AlexanderAdelAU/TMS9900-SBC/Schematics/Readme.md

This folder is a list of the latest and earlier schematics.
