AlexanderAdelAU/TMS9900-SBC/images/Drawings.pptx

TMS99105 SBC Memory Map

Application Memory

0000-F000

BDOS
BDOS.A99

FDC BIOS
MONITOR.A99

DEBUG Monitor
TIMON.A99

RAM

D800-E33C

E600-EE2E

F000-FFFF

ROM

## Slide 2

3 ¼ FDD

TMS99105 SBC

RS232

PC Power
Supply

## Slide 3

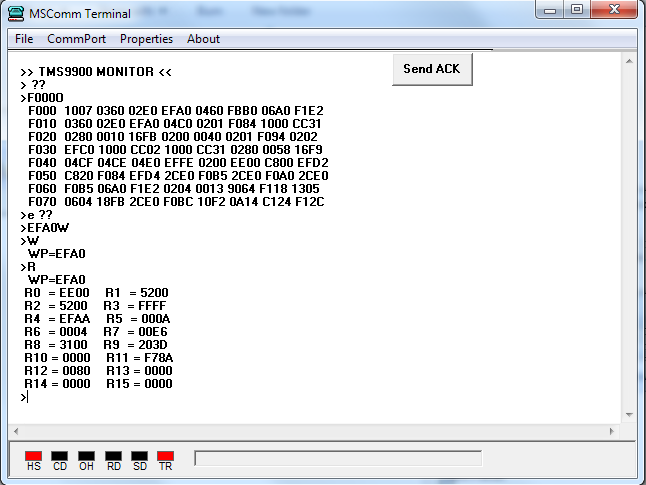
[picture p8: figure]

## Slide 4

0000H

2732 EPROM

Mapped out and filled with FFH

DEBUG Monitor

E000H

ROM Address Space

0800H

F000H

SBC Address Space

HIGH Byte

LOW Byte

1000H

FFFFH

## Slide 5

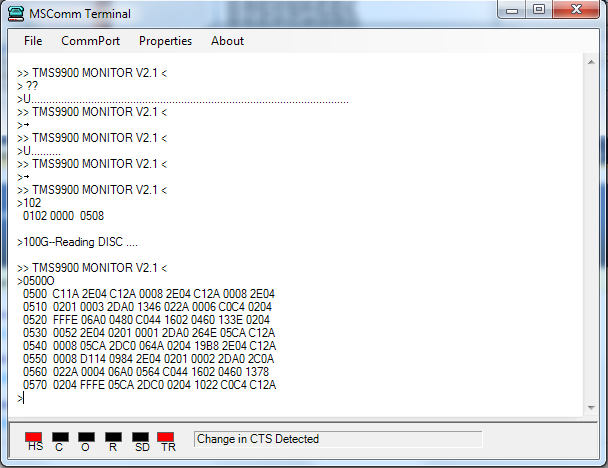
[picture p9: figure]

Reading in MONITOR.H99

Reading in READSEC.H99

Specify Track 5, Sector 8

Dumping Buffer at 0500H
