AlexanderAdelAU/TMS9900-SBC/images/2015-01-13 10.45.29.jpg

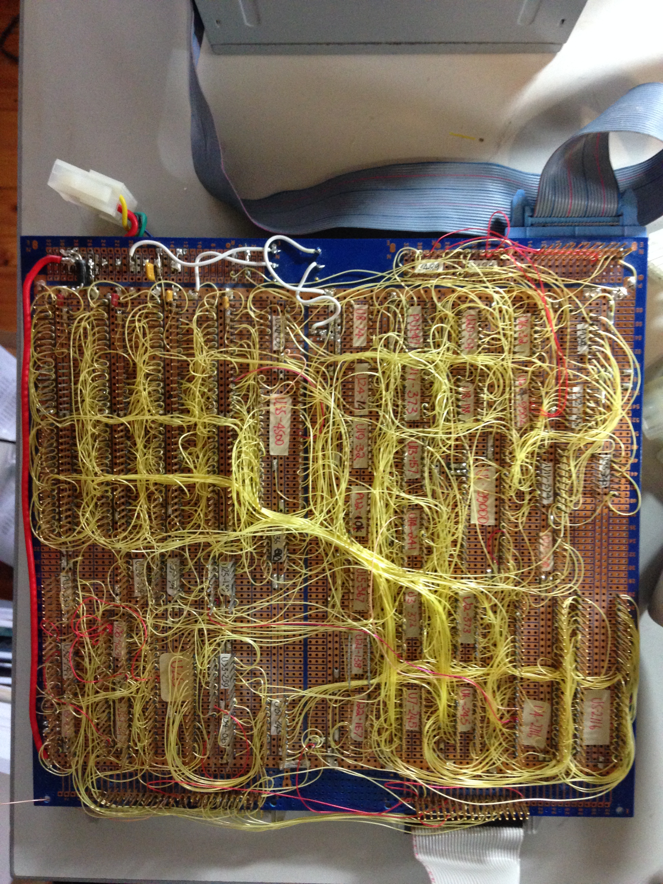
images/2015-01-13 10.45.29.jpg
