AlexanderAdelAU/TMS9900-SBC/images/2015-01-13 10.47.38.jpg

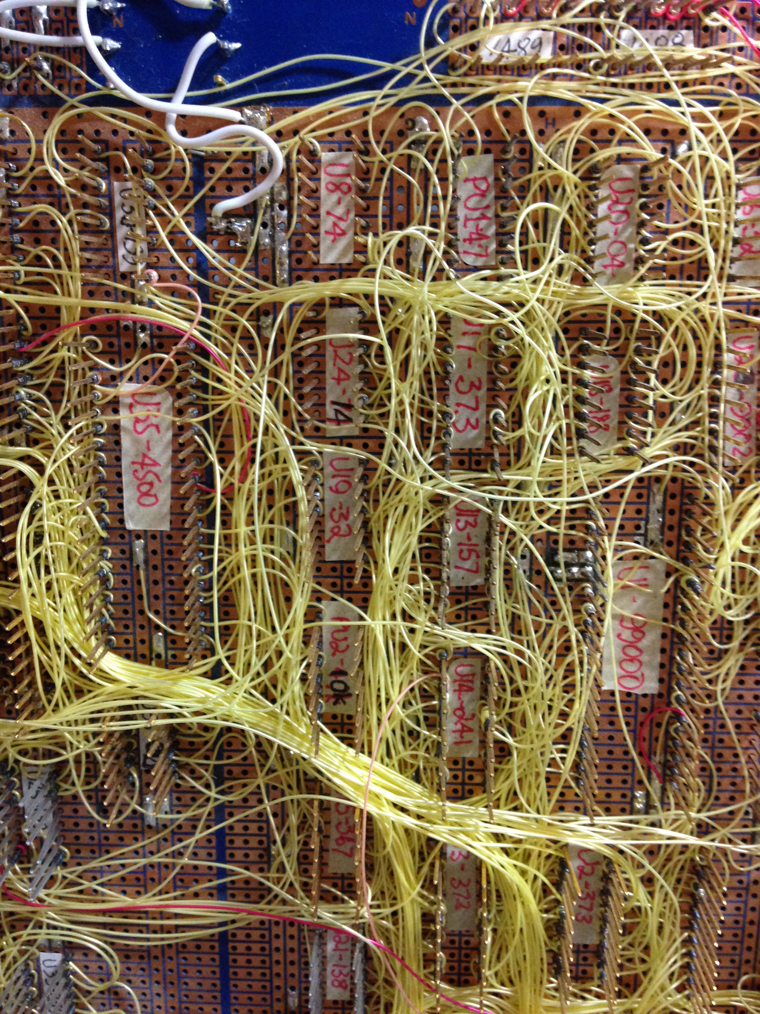
images/2015-01-13 10.47.38.jpg
