AlexanderAdelAU/TMS9900-SBC/images/CommunicationsInterface.png

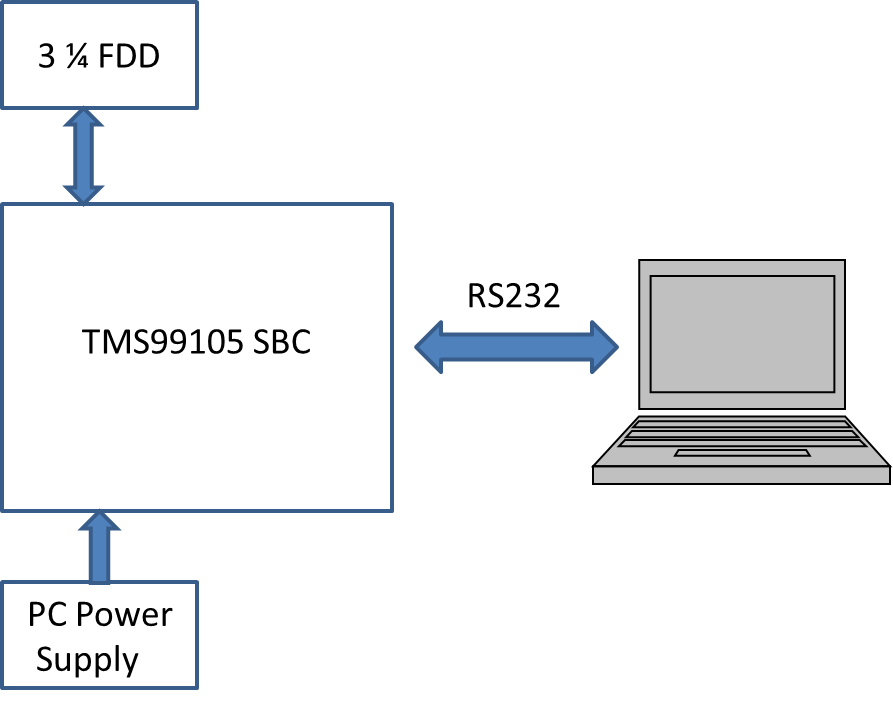
images/CommunicationsInterface.png
