AlexanderAdelAU/TMS9900-SBC/images/MemoryMap.jpg

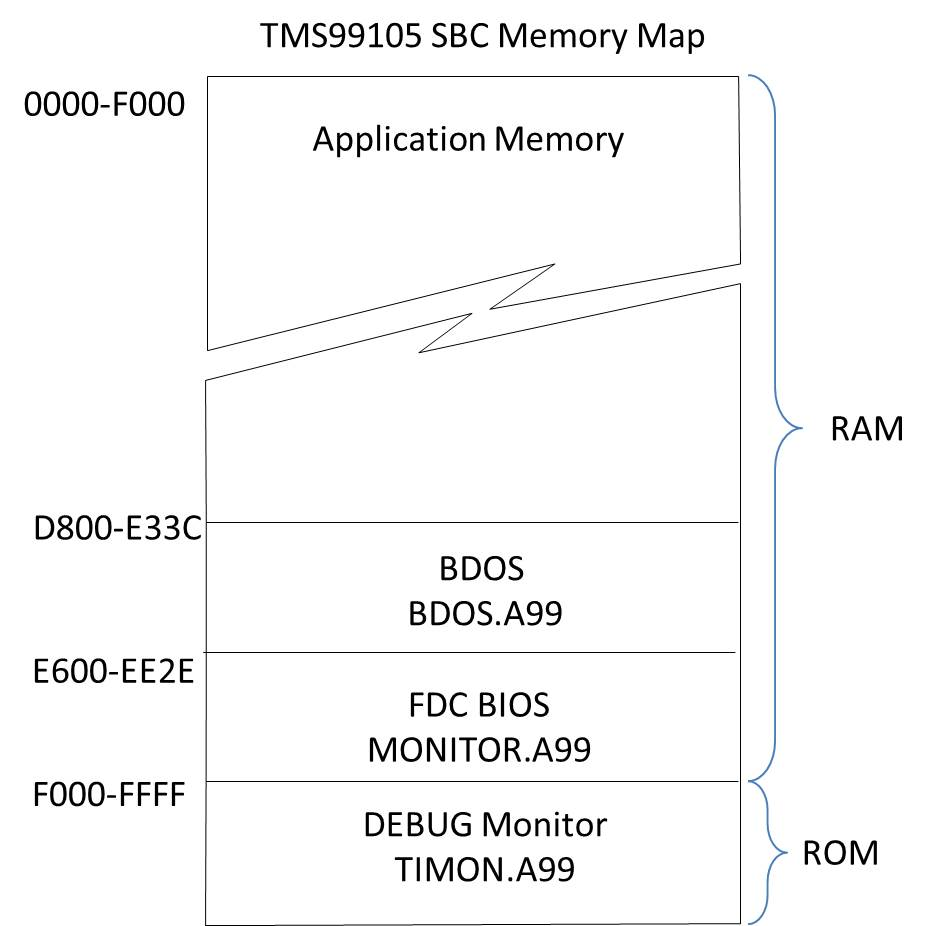
images/MemoryMap.jpg
