AlexanderAdelAU/TMS9900-SBC/images/MemoryMap.png

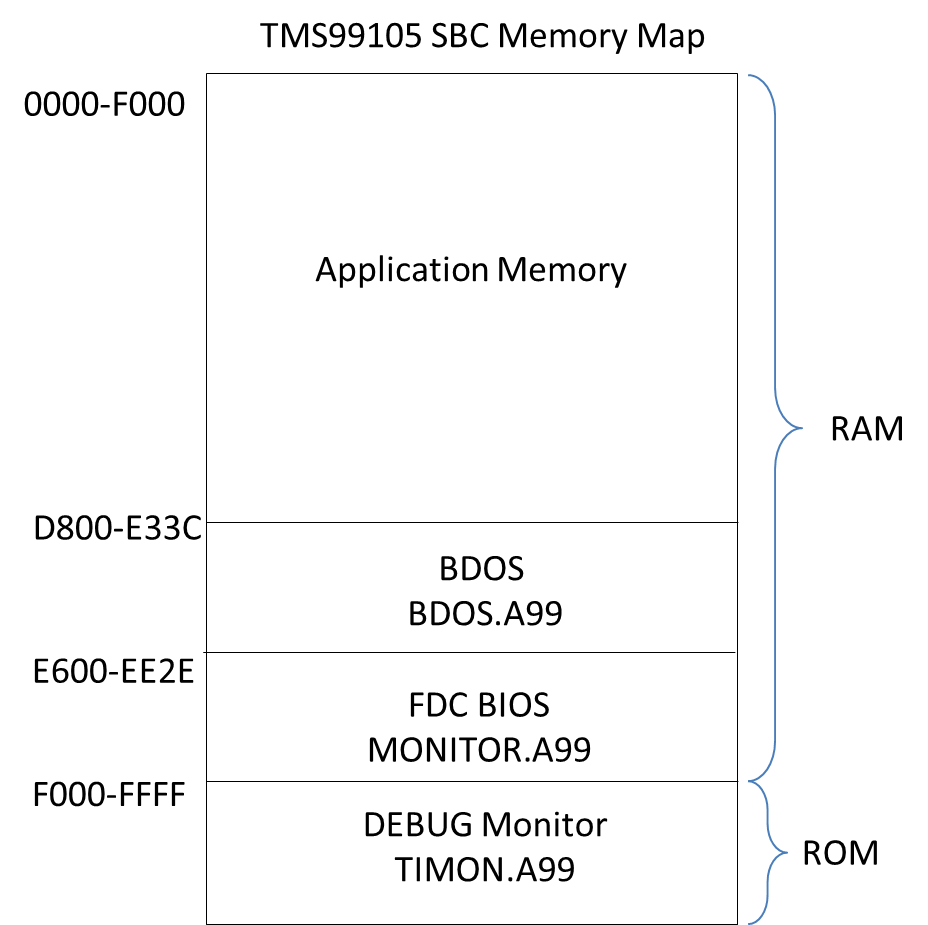
images/MemoryMap.png
