AlexanderAdelAU/TMS9900-SBC/images/TMS9900 Chip SBC.jpg

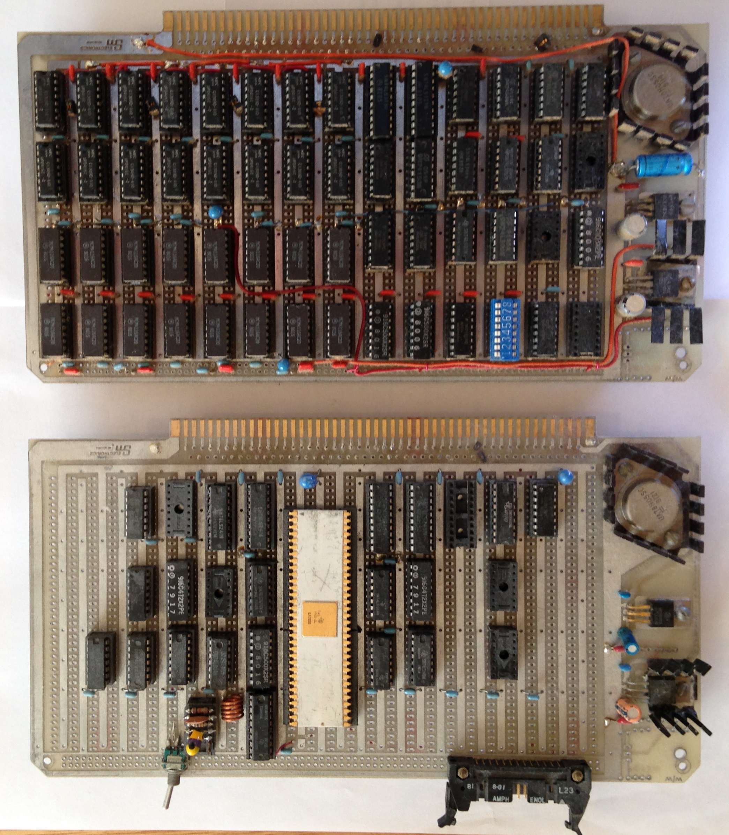
images/TMS9900 Chip SBC.jpg
