AlexanderAdelAU/TMS9900-SBC/images/TMS99105SBC1_standard.jpg

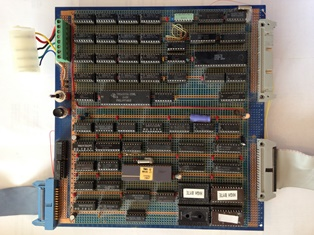
images/TMS99105SBC1_standard.jpg
