AlexanderAdelAU/TMS9900-SBC/images/Wellon Programmer.png

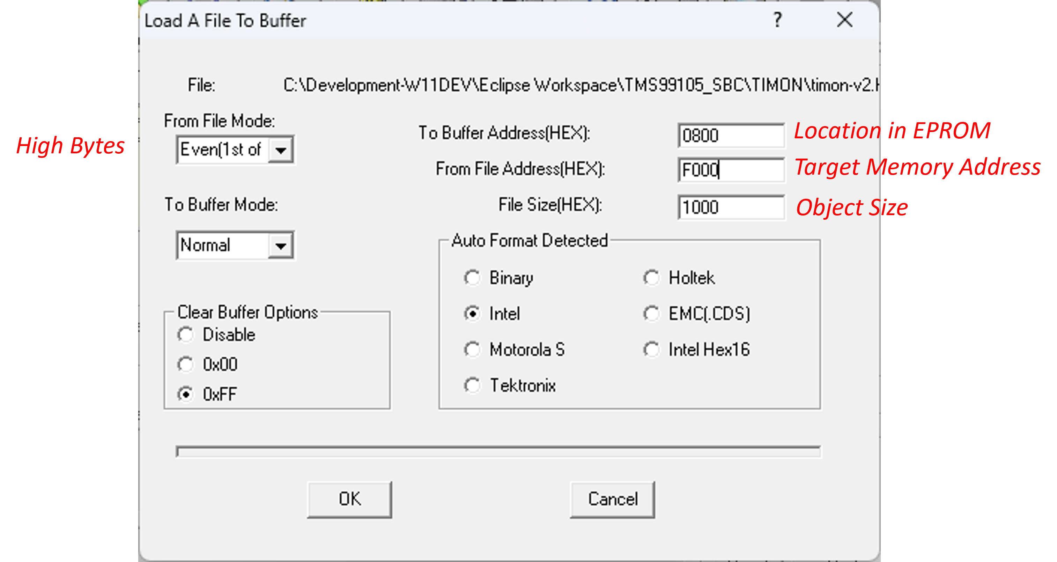
images/Wellon Programmer.png
