AlexanderAdelAU/TMS9900-SBC/images/DEBUG_MONITOR_MEMORY_MAP.png

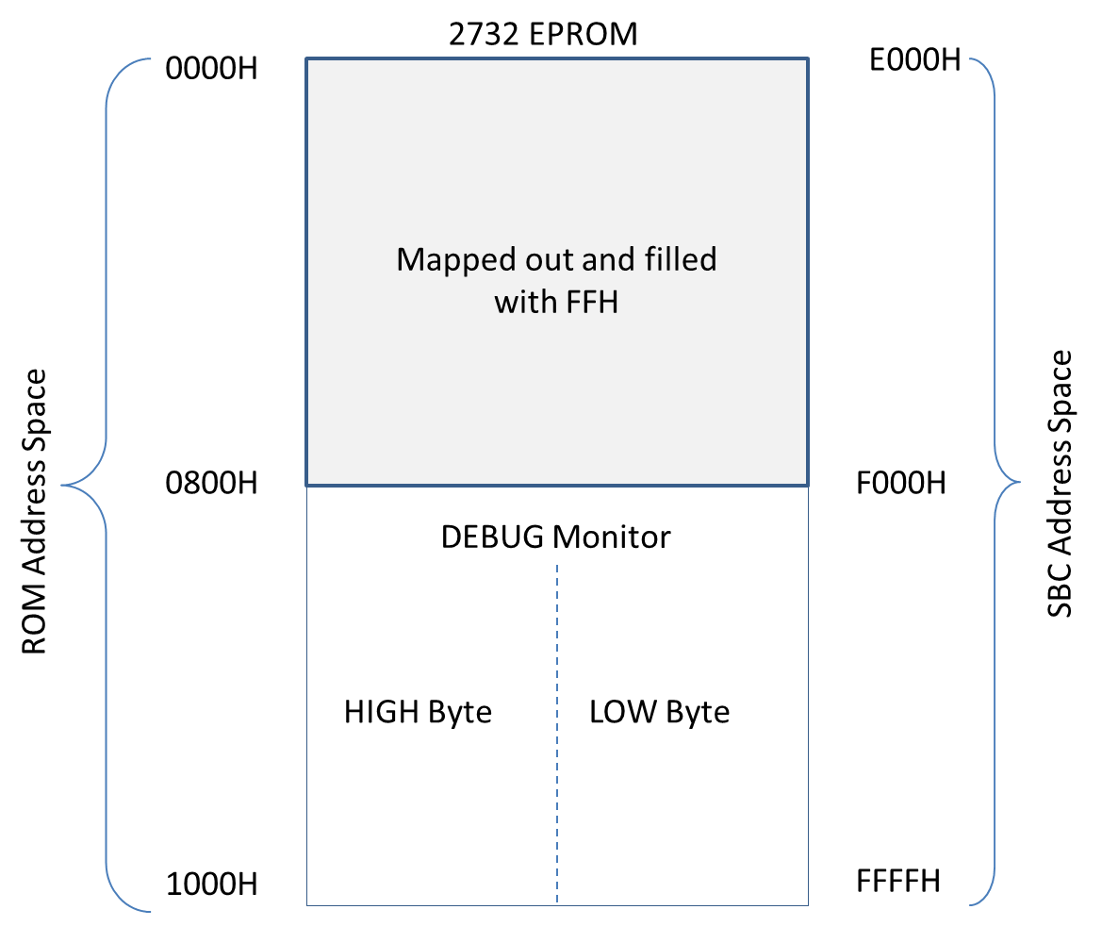
images/DEBUG_MONITOR_MEMORY_MAP.png
