AlexanderAdelAU/TMS9900-SBC/Schematics/TMS99105_SBC_Schematic_v4.pdf

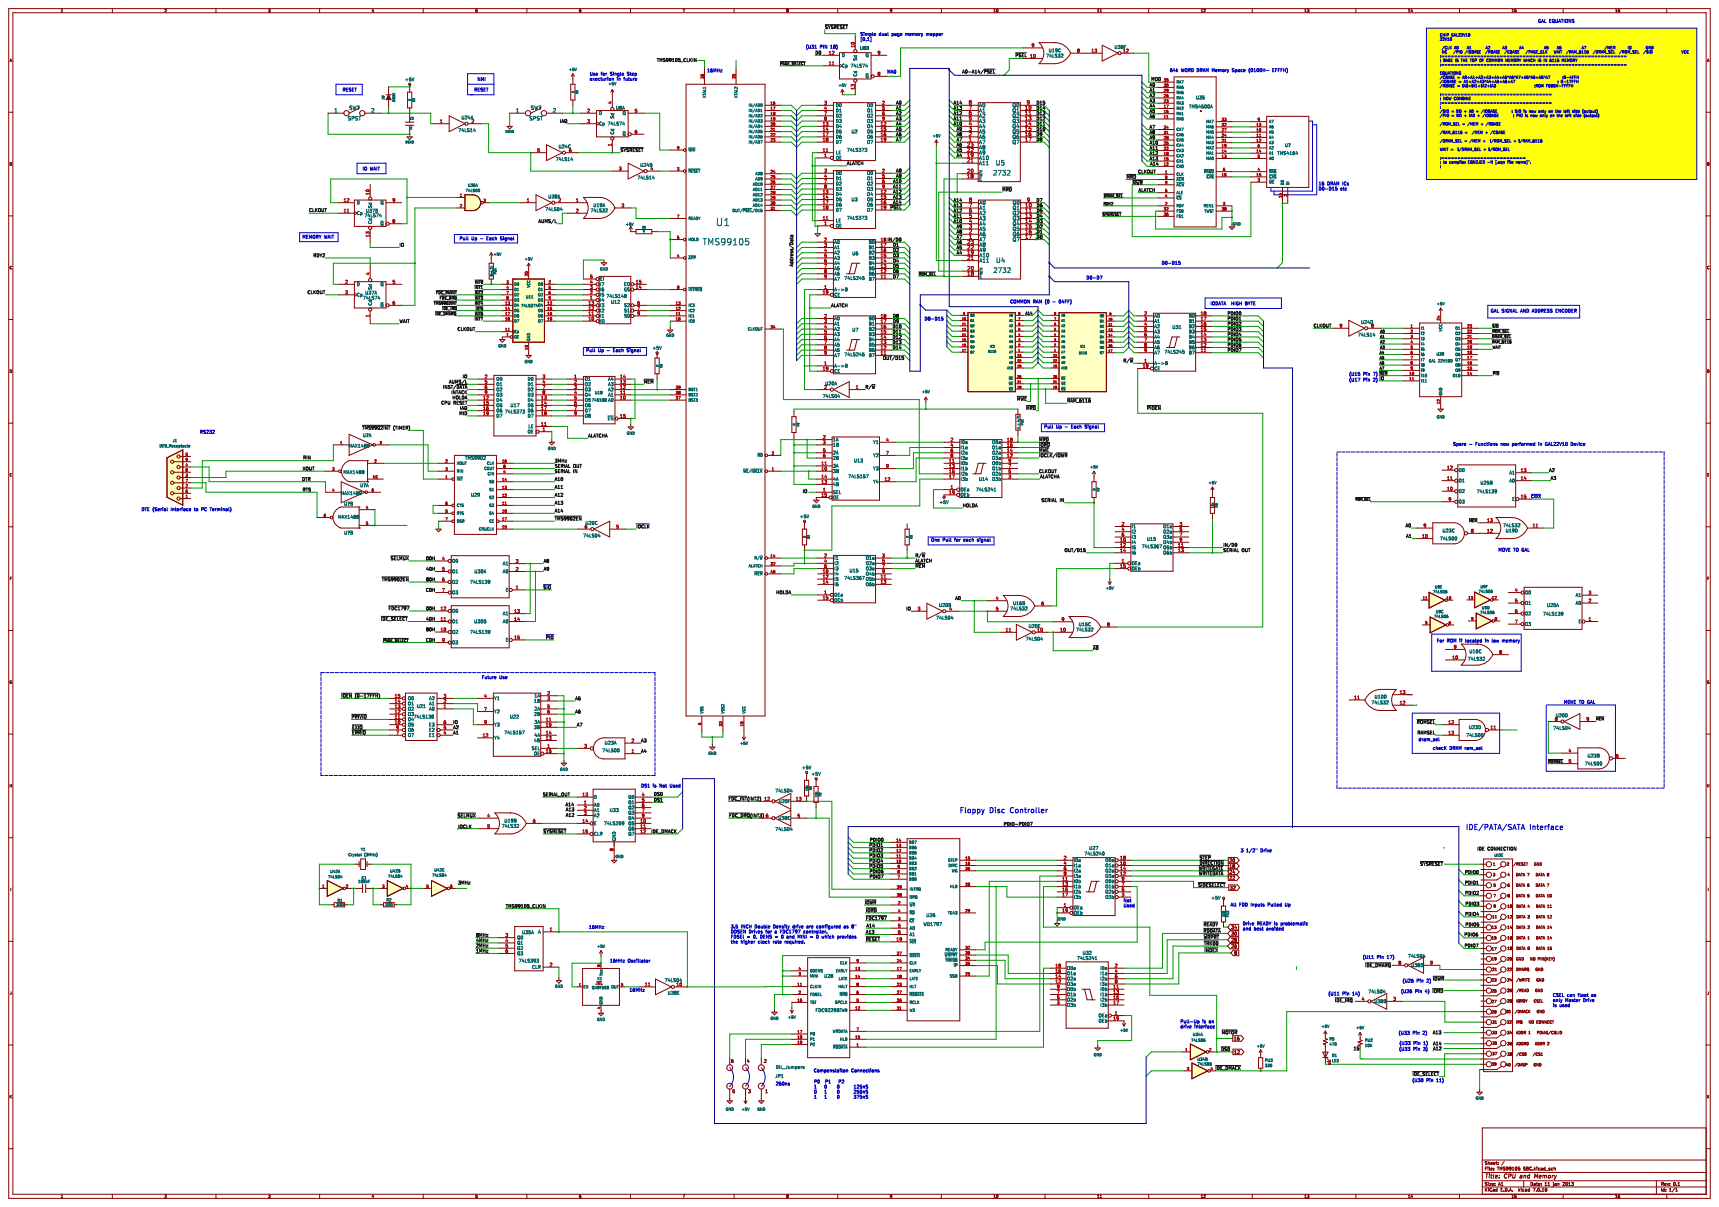
[picture p20: page 1]
