AlexanderAdelAU/TMS9900-SBC/Schematics/TMS99105 SBC Schematic v3.pdf

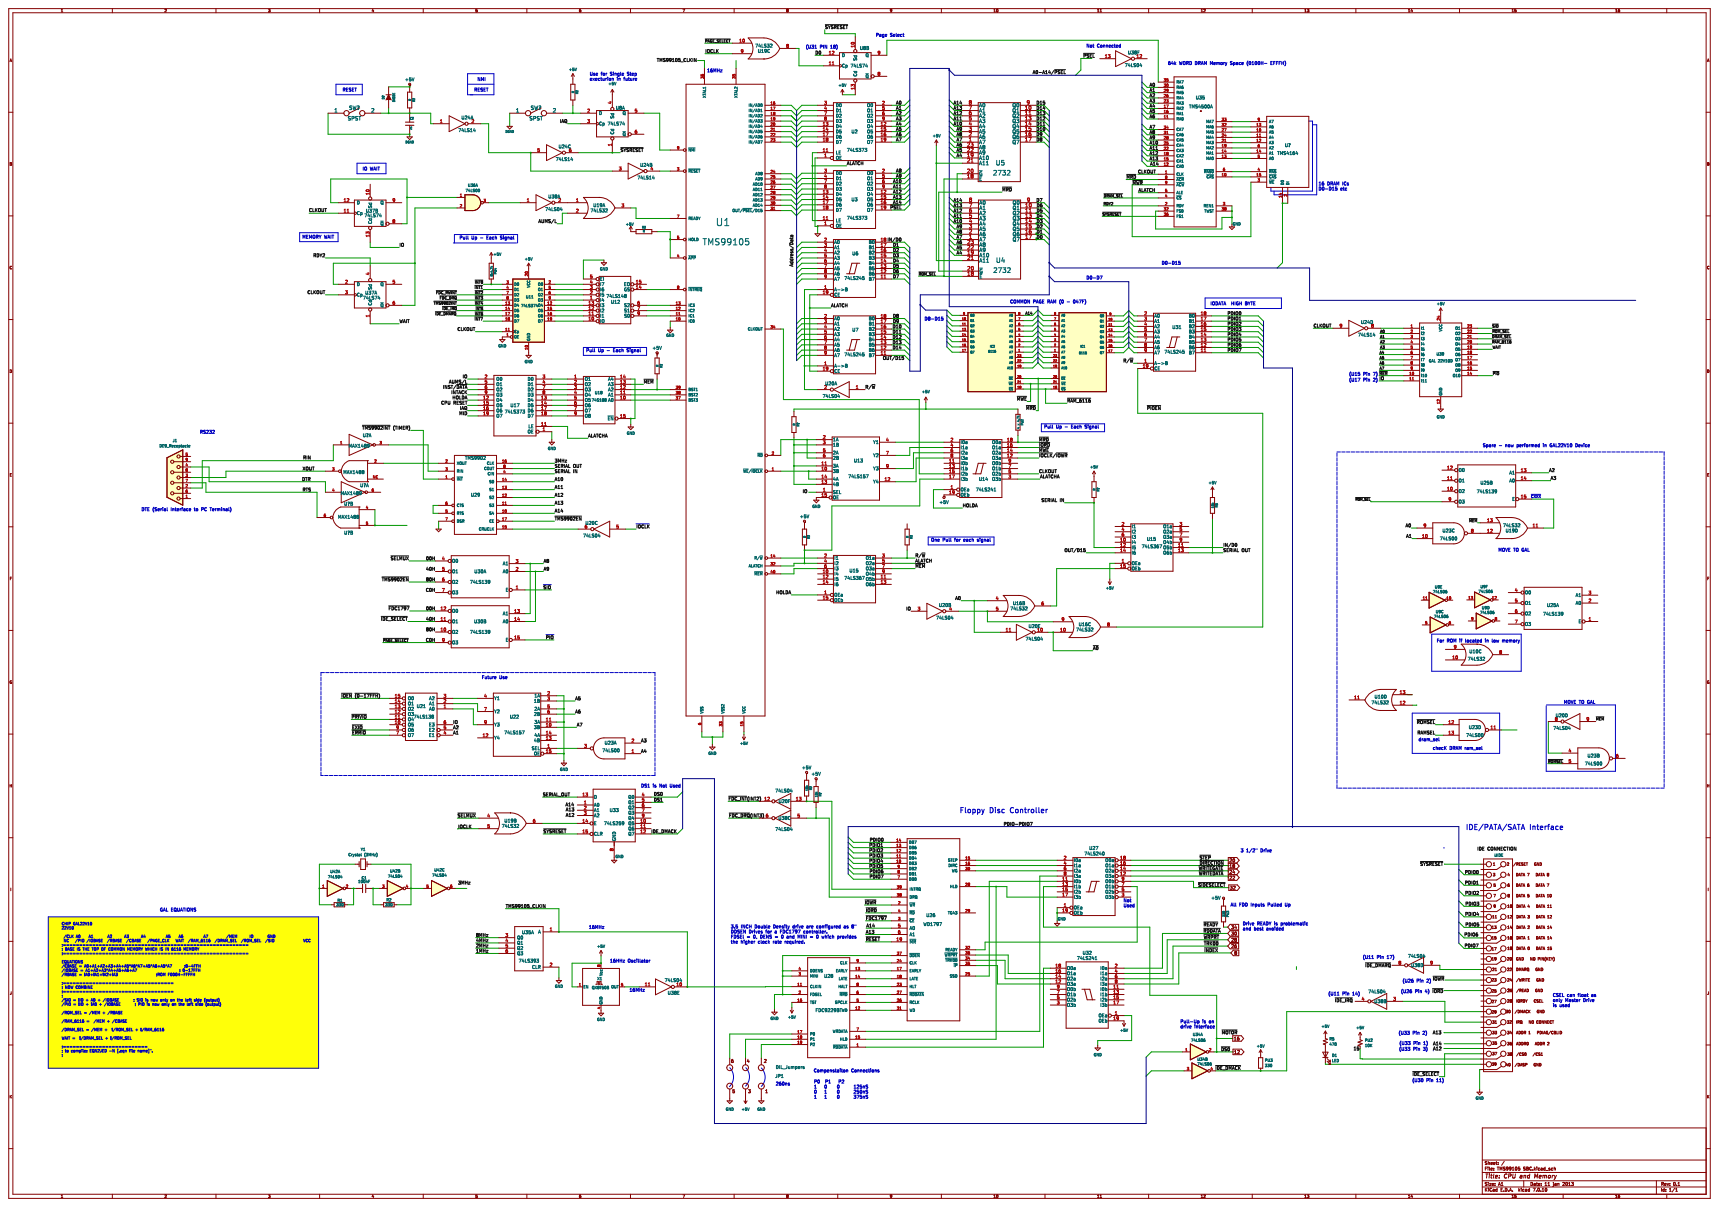
[picture p21: page 1]
