AlexanderAdelAU/TMS9900-SBC/Schematics/TMS99000_SBC_Schematic_v2.pdf

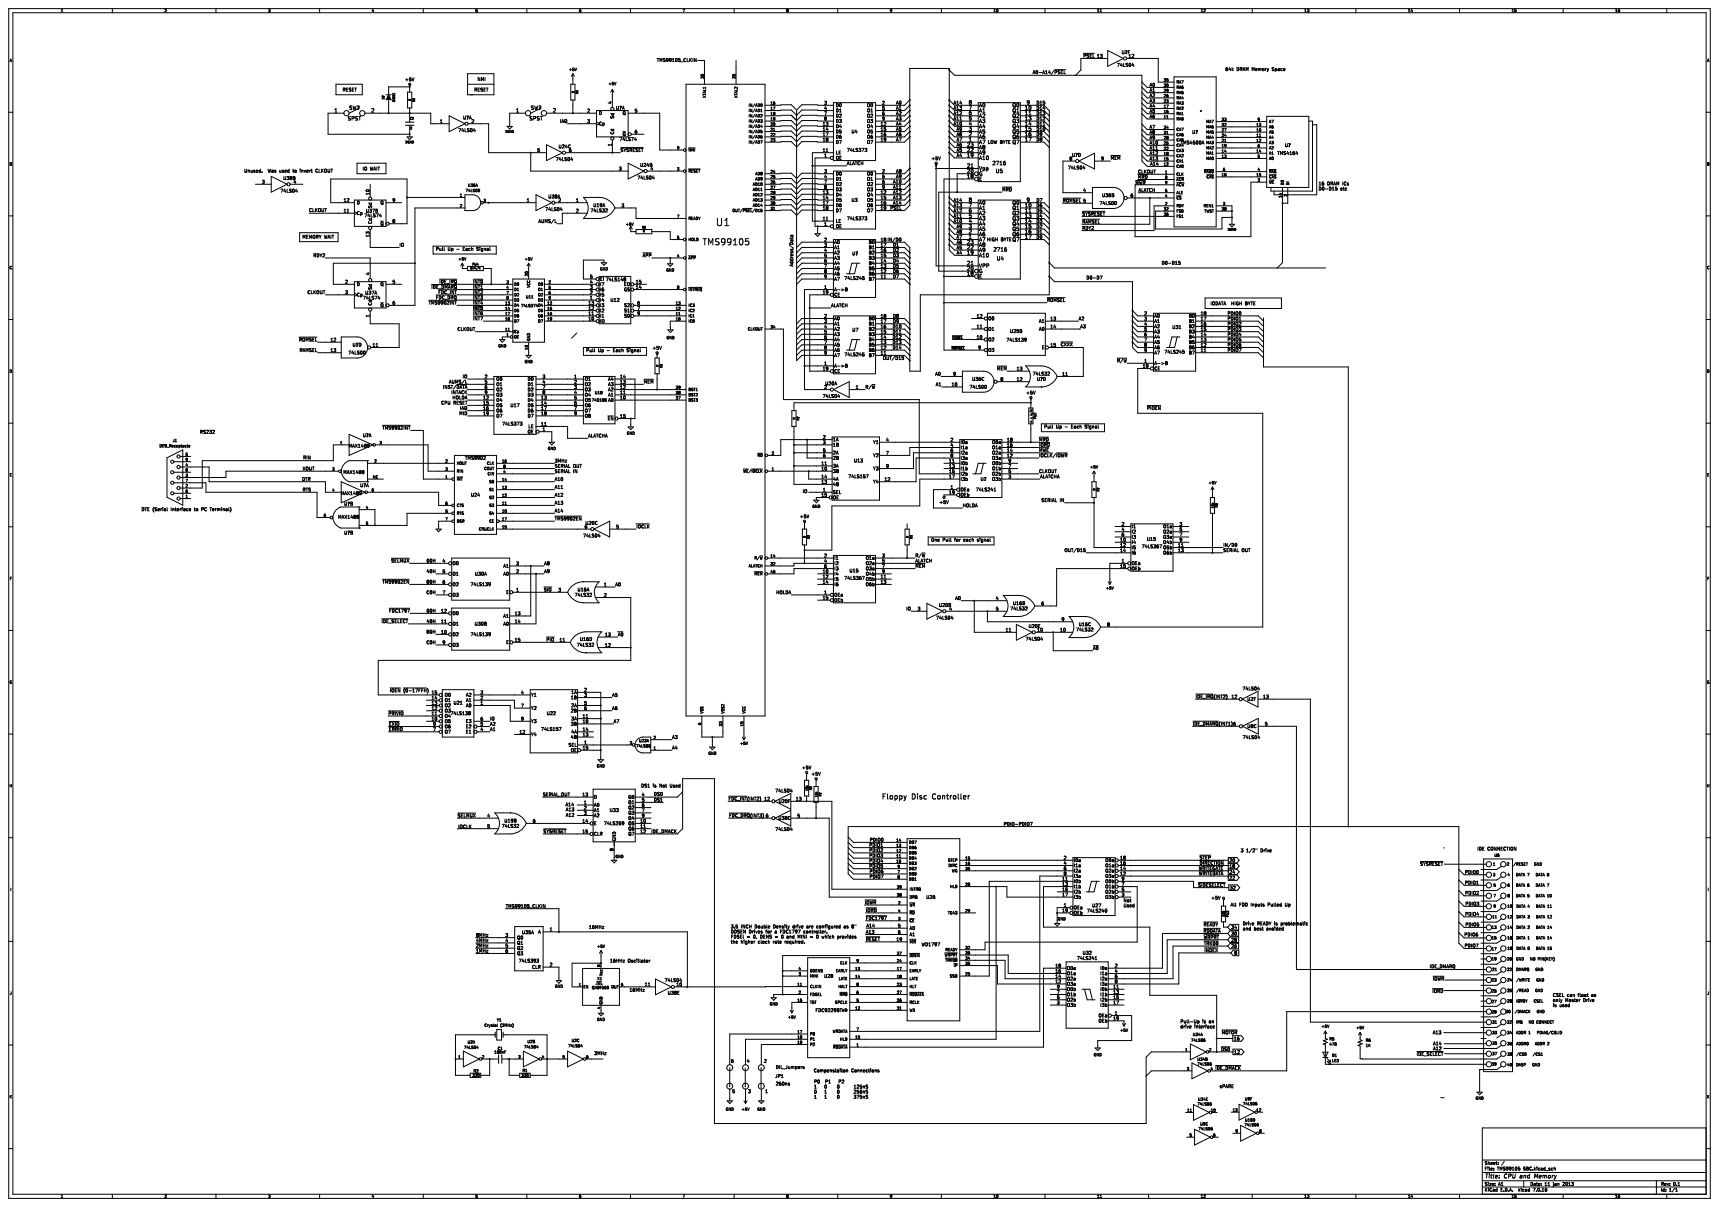
[picture p22: page 1]
