AlexanderAdelAU/TMS9900-SBC/Schematics/tms99105a_sbc_Schematic.pdf

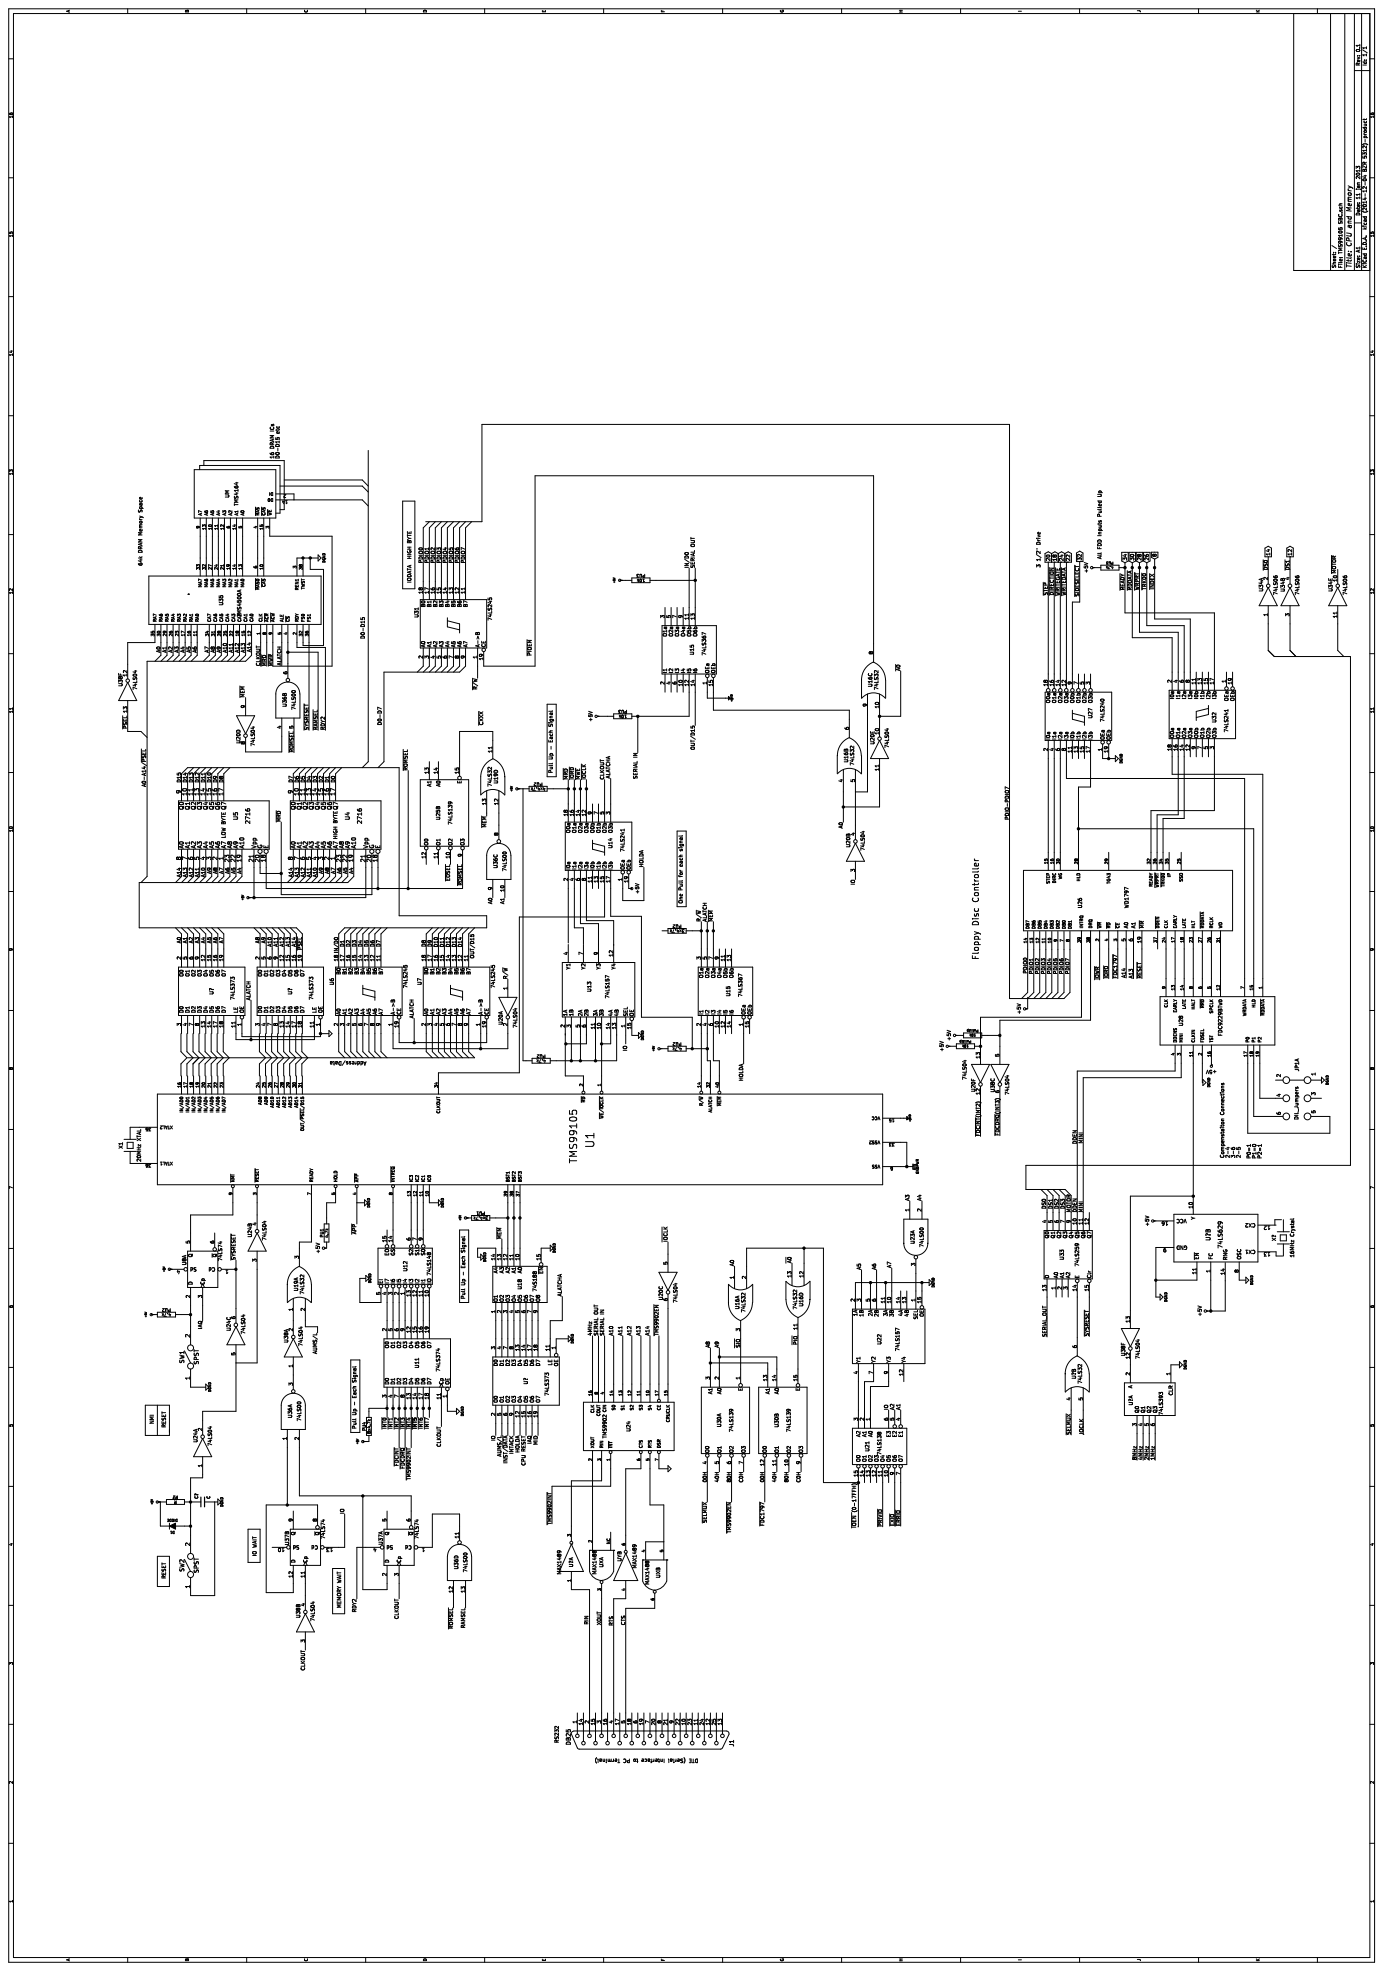
[picture p23: page 1]
