AlexanderAdelAU/TMS9900-SBC/Schematics/FDC.sch

## KiCad design Schematics/FDC.sch (2024-01-18, last stored version)

Schematic: FDC.sch

Parts:
J2: J2 - 34
J2-27, J2-28: JCON

Notes on the sheet:
34 PIN DIL CONNECTOR
3 1/4 Floppy Interface Pins
