AlexanderAdelAU/TMS9900-SBC/Schematics/TMS99105 SBC-reovered.sch

## KiCad design Schematics/TMS99105 SBC-reovered.sch (2024-01-18, last stored version)

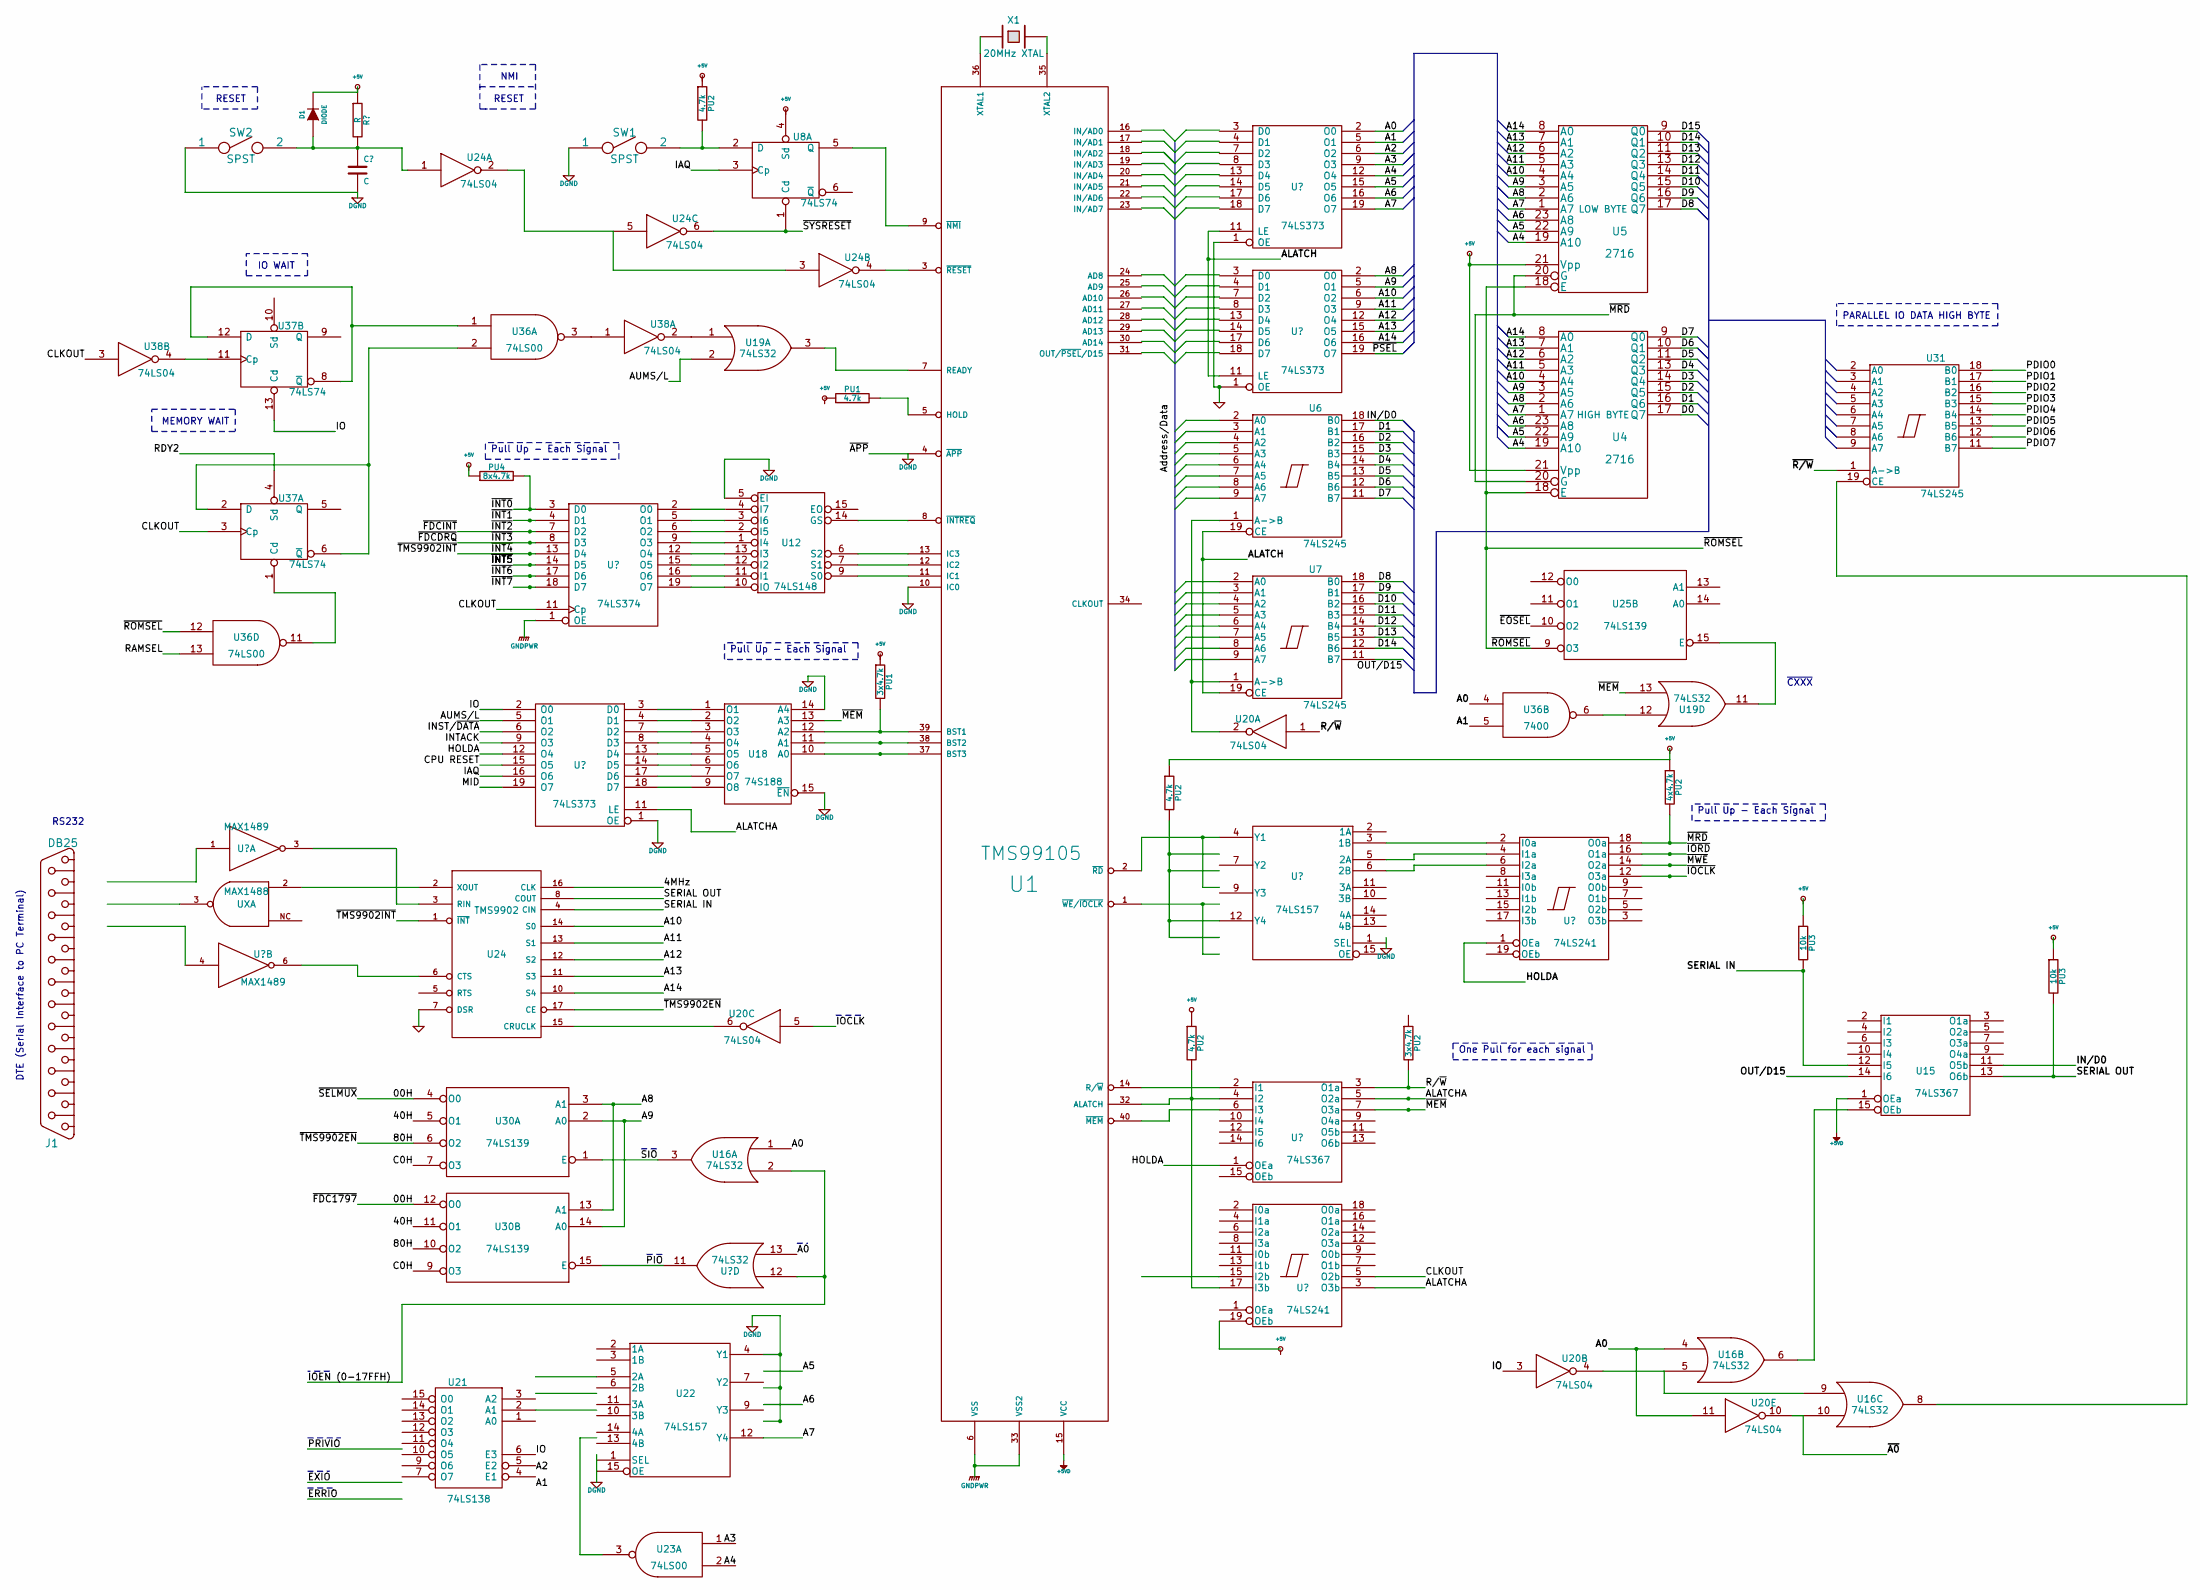
[picture p24: schematic TMS99105 SBC-reovered.sch]

Parts:
D1: DIODE
J1: DB25
PU1, PU2: 4.7k
PU3: 10k
PU4: 8x4.7k
SW1, SW2: SPST
U1: TMS99105
U4, U5: 2716
U6, U7, U31: 74LS245
U8, U37: 74LS74
U12: 74LS148
U15: 74LS367
U16, U19: 74LS32
U18: 74S188
U20, U24, U38: 74LS04
U21: 74LS138
U22: 74LS157
U23: 74LS00
U25, U30: 74LS139
U36: 7400
UX: MAX1488
X1: 20MHz XTAL

Connections:
00H: U30.4 (O0), U30.12 (O0)
4MHz: U24.16 (CLK)
40H: U30.5 (O1), U30.11 (O1)
80H: U24.17 (CE), U30.6 (O2), U30.10 (O2)
+5V: D1.2 (K), PU2.1, PU3.1, PU4.1, U4.21 (Vpp), U5.21 (Vpp)
+5VD: U1.15 (VCC), U15.1 (OEa)
A0: U16.1, U16.4, U20.11, U36.4
A1: U36.5
A4: U4.19 (A10), U5.19 (A10)
A5: U4.22 (A9), U5.22 (A9)
A6: U4.23 (A8), U5.23 (A8)
A7: U4.1 (A7), U5.1 (A7), U22.12 (Y4)
A8: U4.2 (A6), U5.2 (A6), U30.3 (A1), U30.13 (A1)
A9: U4.3 (A5), U5.3 (A5), U30.2 (A0), U30.14 (A0)
A10: U4.4 (A4), U5.4 (A4), U24.14 (S0)
A11: U4.5 (A3), U5.5 (A3), U24.13 (S1)
A12: U4.6 (A2), U5.6 (A2), U24.12 (S2)
A13: U4.7 (A1), U5.7 (A1), U24.11 (S3)
A14: U4.8 (A0), U5.8 (A0), U24.10 (S4)
ALATCH: U6.19 (CE), U7.19 (CE)
AUMS/L: U19.2
C0H: U30.7 (O3), U30.9 (O3)
CLKOUT: U37.3 (Cp), U38.3
D0: U4.17 (Q7)
D1: U4.16 (Q6), U6.17 (B1)
D2: U4.15 (Q5), U6.16 (B2)
D3: U4.14 (Q4), U6.15 (B3)
D4: U4.13 (Q3), U6.14 (B4)
D5: U4.11 (Q2), U6.13 (B5)
D6: U4.10 (Q1), U6.12 (B6)
D7: U4.9 (Q0), U6.11 (B7)
D8: U5.17 (Q7), U7.18 (B0)
D9: U5.16 (Q6), U7.17 (B1)
D10: U5.15 (Q5), U7.16 (B2)
D11: U5.14 (Q4), U7.15 (B3)
D12: U5.13 (Q3), U7.14 (B4)
D13: U5.11 (Q2), U7.13 (B5)
D14: U5.10 (Q1), U7.12 (B6)
D15: U5.9 (Q0)
DGND: SW1.1, U1.10 (IC0), U18.15 (~EN)
GND: U24.7 (DSR)
GNDPWR: U1.6 (VSS), U1.33 (VSS2)
IAQ: U8.3 (Cp)
IN/D0: U6.18 (B0), U15.11 (O5b)
IO: U20.3, U21.6 (E3), U37.13 (Cd)
IOCLK: U20.5
IOEN (0-17FFH): U16.2
unnamed: D1.1 (A), SW2.2, U24.1 (~INT)
unnamed: PU1.2, U1.5 (HOLD), U1.39 (BST1), U18.12 (A2)
unnamed: PU2.2, SW1.2, U1.32 (ALATCH), U8.2 (D)
unnamed: U1.3 (~RESET), U24.4 (CIN)
unnamed: U1.7 (READY), U19.3
unnamed: U1.8 (~INTREQ), U12.14 (GS)
unnamed: U1.9 (~NMI), U8.5 (Q)
unnamed: U1.11 (IC1), U12.9 (S0)
unnamed: U1.12 (IC2), U12.7 (S1)
unnamed: U1.13 (IC3), U12.6 (S2)
unnamed: U1.35 (XTAL2), X1.2
unnamed: U1.36 (XTAL1), X1.1
unnamed: U1.37 (BST3), U18.10 (A0)
unnamed: U1.38 (BST2), U18.11 (A1)
unnamed: U15.15 (OEb), U16.6
unnamed: U16.5, U16.9, U20.4
unnamed: U16.8, U31.19 (CE)
unnamed: U19.1, U38.2
unnamed: U19.11, U25.15 (E)
unnamed: U19.12, U36.6
unnamed: U6.1 (A->B), U7.1 (A->B), U20.2
unnamed: U20.6, U24.15 (CRUCLK)
unnamed: U24.2 (XOUT), U24.3 (RIN), U24.5 (RTS), UX.2
unnamed: U36.1, U37.8 (~Q), U37.12 (D)
unnamed: U36.2, U37.2 (D), U37.6 (~Q)
unnamed: U36.3, U38.1
unnamed: U36.11, U37.1 (Cd)
unnamed: U37.11 (Cp), U38.4
OUT/D15: U15.14 (I6)
PDIO0: U31.18 (B0)
PDIO1: U31.17 (B1)
PDIO2: U31.16 (B2)
PDIO3: U31.15 (B3)
PDIO4: U31.14 (B4)
PDIO5: U31.13 (B5)
PDIO6: U31.12 (B6)
PDIO7: U31.11 (B7)
PIO: U30.15 (E)
R/~W: PU2.2, U20.1
RAMSEL: U36.13
RDY2: U37.4 (Sd)
SERIAL IN: PU3.2, U15.12 (I5), U24.4 (CIN)
SERIAL OUT: PU3.2, U15.13 (O6b), U24.8 (COUT)
SIO: U16.3, U30.1 (E)
~A0: U16.10, U20.10
~APP: U1.4 (~APP)
~EOSEL: U25.10 (O2)
~INT0: PU4.2
~INT4: U24.1 (~INT)
~MEM: U18.13 (A3), U19.13
~MRD: PU2.2, U4.20 (G), U5.20 (G)
~R/W~: U31.1 (A->B)
~ROMSEL: U4.18 (E), U5.18 (E), U25.9 (O3), U36.12
~SYSRESET: U8.1 (Cd), U24.6 (CTS)

Notes on the sheet:
Pull Up - Each Signal
~CXXX
PARALLEL IO DATA HIGH BYTE
One Pull for each signal
RESET
MEMORY WAIT
IO WAIT
NMI
RS232
DTE (Serial Interface to PC Terminal)
