AlexanderAdelAU/TMS9900-SBC/Schematics/TMS99105 SBC.sch

## KiCad design Schematics/TMS99105 SBC.sch (2024-01-18, last stored version)

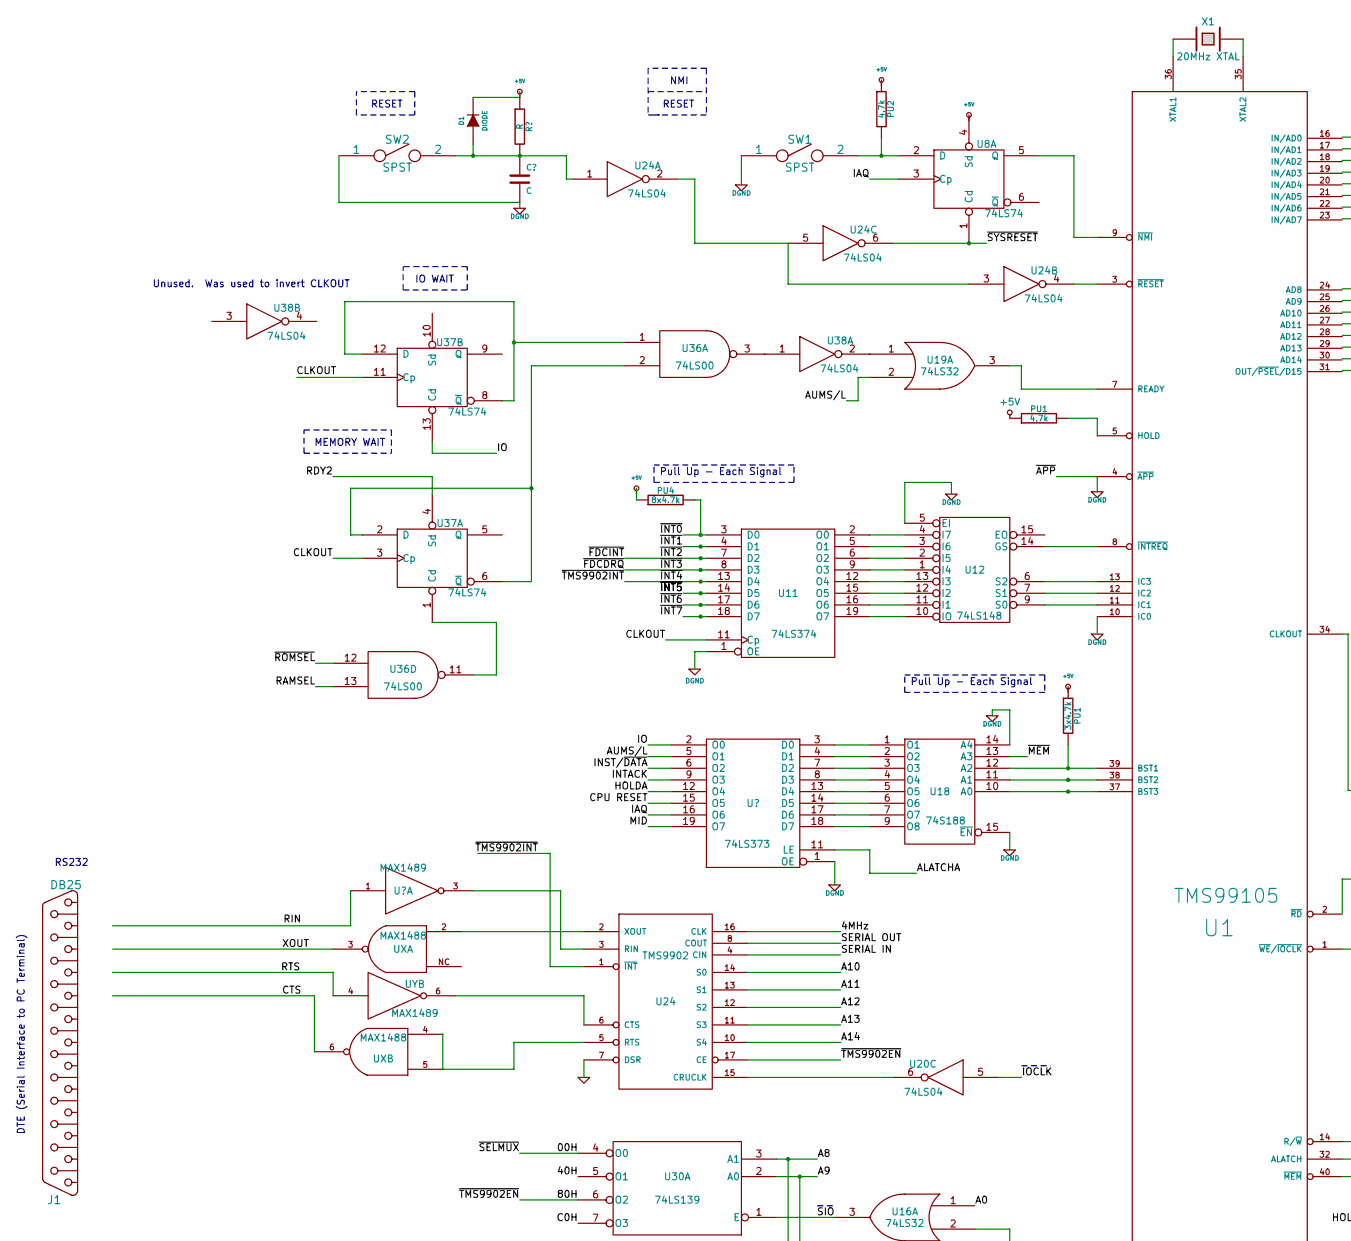
[picture p25: schematic TMS99105 SBC.sch, part in row 1, column 1]

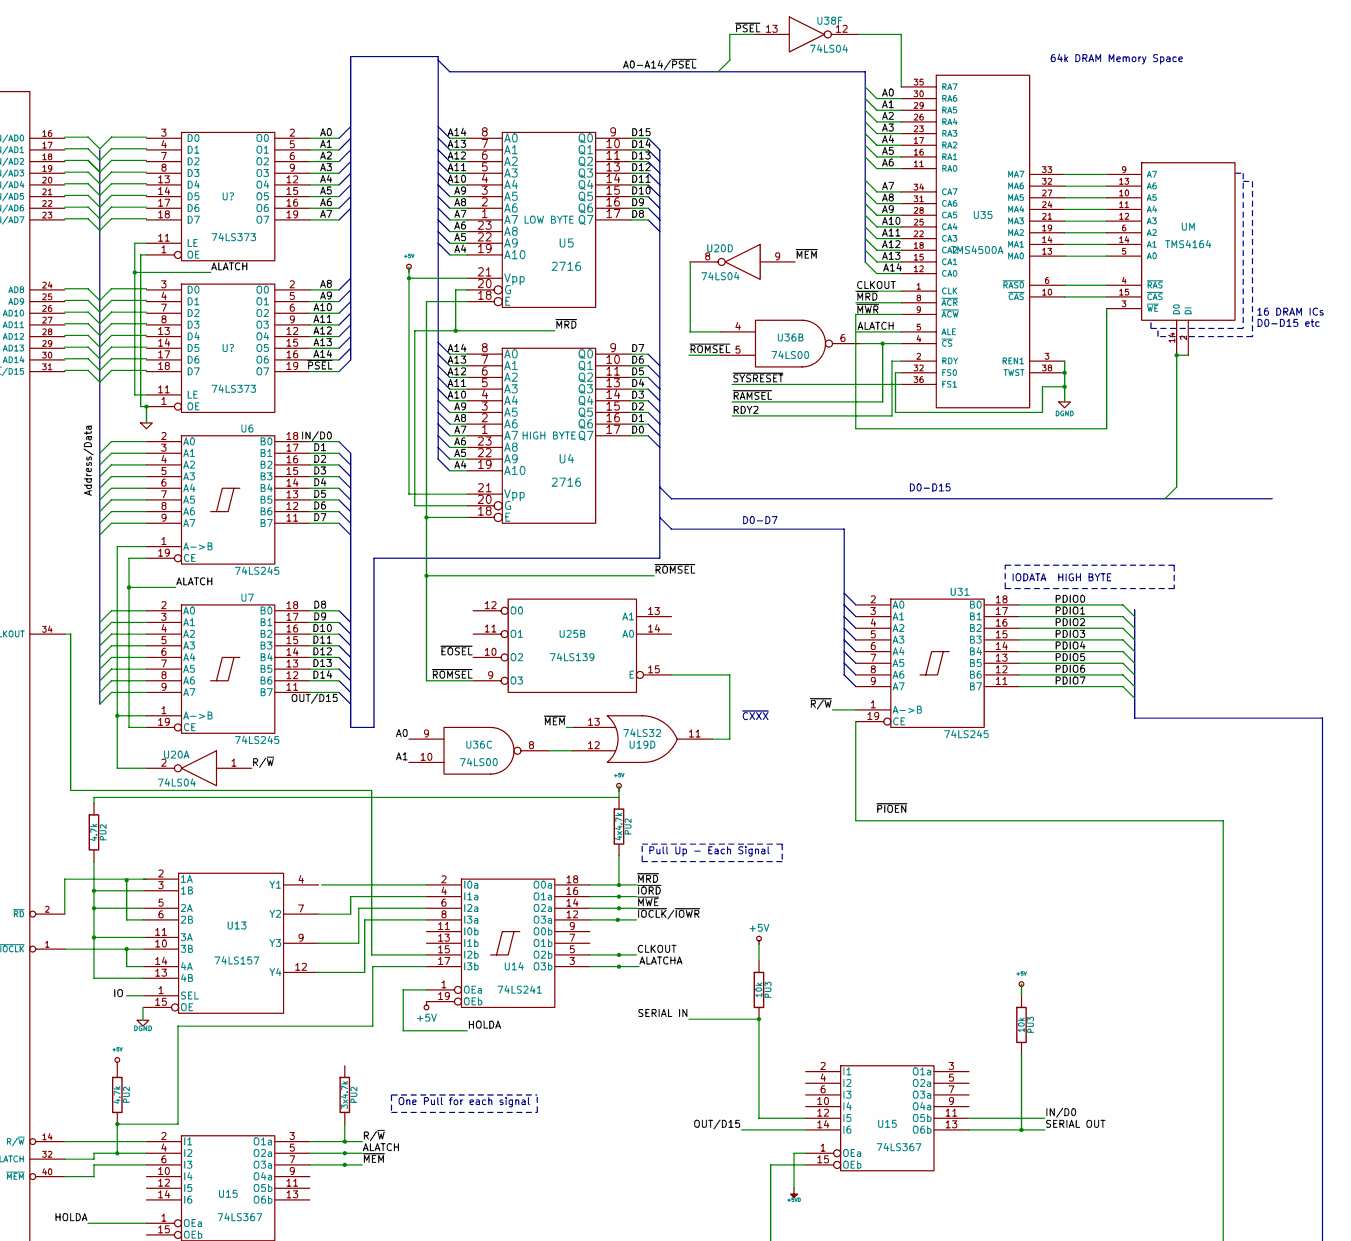
[picture p26: schematic TMS99105 SBC.sch, part in row 1, column 2]

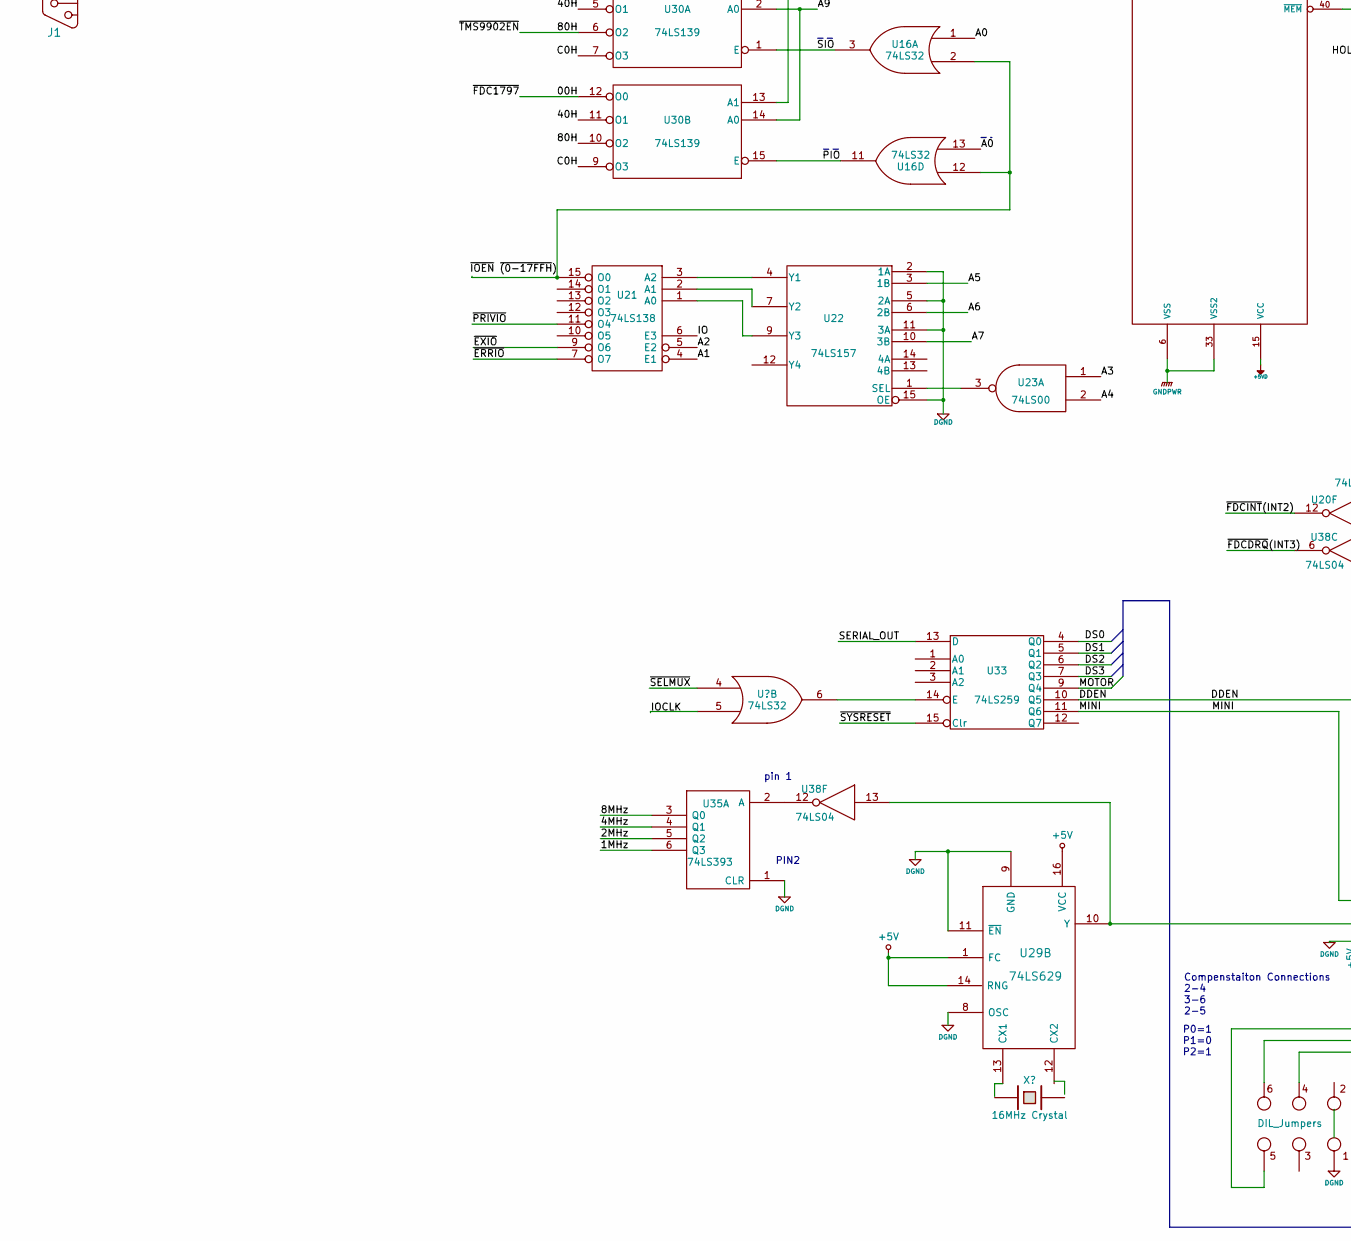
[picture p27: schematic TMS99105 SBC.sch, part in row 2, column 1]

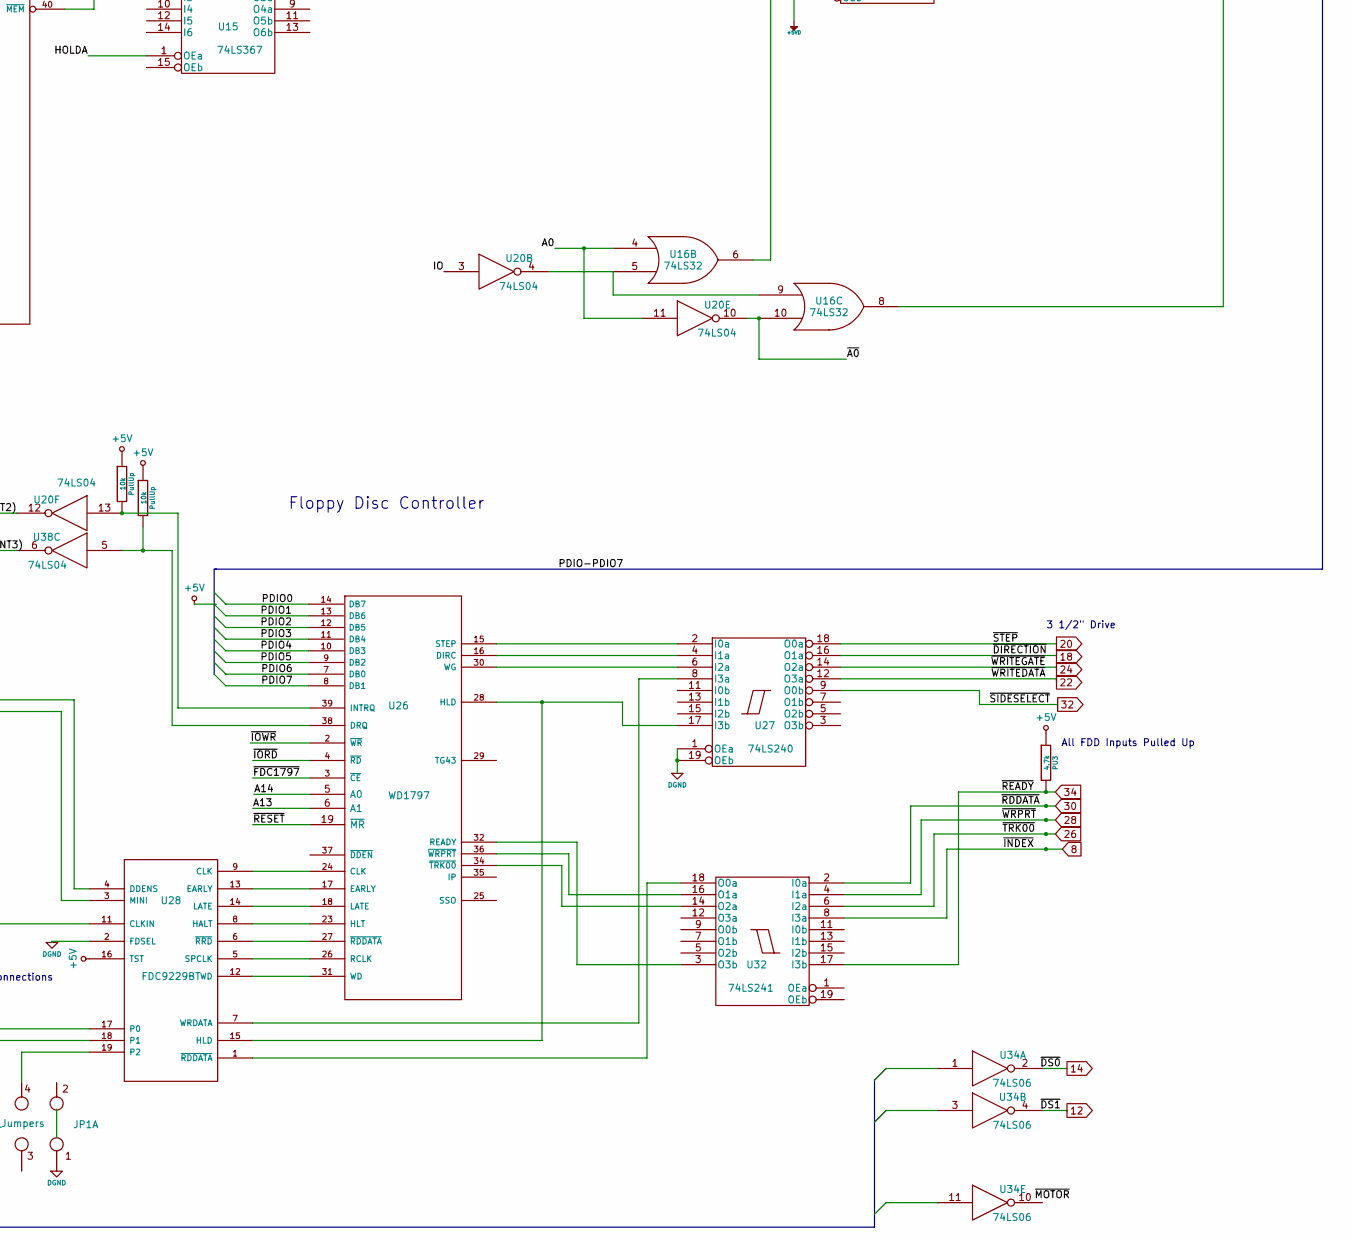
[picture p28: schematic TMS99105 SBC.sch, part in row 2, column 2]

Parts:
D1: DIODE
J1: DB25
JP1: DIL_Jumpers
PU1, PU2: 4.7k
PU3: 10k
PU4: 8x4.7k
PullUp: 10k
SW1, SW2: SPST
U1: TMS99105
U4, U5: 2716
U6, U7, U31: 74LS245
U8, U37: 74LS74
U11: 74LS374
U12: 74LS148
U13, U22: 74LS157
U14, U32: 74LS241
U15: 74LS367
U16, U19: 74LS32
U18: 74S188
U20, U24, U38: 74LS04
U21: 74LS138
U23, U36: 74LS00
U25, U30: 74LS139
U26: WD1797
U27: 74LS240
U28: FDC9229BT
U29: 74LS629
U33: 74LS259
U34: 74LS06
U35: TMS4500A
UM: TMS4164
UX: MAX1488
UY: MAX1489
X1: 20MHz XTAL

Connections:
00H: U26.3 (~CE), U30.4 (O0), U30.12 (O0)
1MHz: U35.6 (Q3)
2MHz: U35.5 (Q2)
4MHz: U24.16 (CLK), U35.4 (Q1)
8: U32.8 (I3a)
8MHz: U35.3 (Q0)
12: U34.4
14: U34.2
18: U27.16 (O1a)
20: U27.18 (O0a)
22: U27.12 (O3a)
24: U27.14 (O2a)
26: U32.6 (I2a)
28: U32.4 (I1a)
30: U32.2 (I0a)
32: U27.9 (O0b)
34: PU3.2, U32.17 (I3b)
40H: U30.5 (O1), U30.11 (O1)
80H: U24.17 (CE), U30.6 (O2), U30.10 (O2)
+5V: D1.2 (K), PU1.1, PU2.1, PU3.1, PU4.1, PullUp.1, U4.21 (Vpp), U5.21 (Vpp), U14.19 (OEb), U28.16 (TST), U29.1 (FC), U29.14 (RNG), U29.16 (VCC)
+5VD: U1.15 (VCC), U15.1 (OEa)
A0: U16.1, U16.4, U16.13, U20.11, U35.30 (RA6), U36.9
A1: U21.4 (E1), U35.29 (RA5), U36.10
A2: U21.5 (E2), U35.26 (RA4)
A3: U23.1, U35.23 (RA3)
A4: U4.19 (A10), U5.19 (A10), U23.2, U35.17 (RA2)
A5: U4.22 (A9), U5.22 (A9), U22.3 (1B), U35.16 (RA1)
A6: U4.23 (A8), U5.23 (A8), U22.6 (2B), U35.11 (Q0)
A7: U4.1 (A7), U5.1 (A7), U22.10 (3B), U35.34 (CA7)
A8: U4.2 (A6), U5.2 (A6), U30.3 (A1), U30.13 (A1), U35.31 (CA6)
A9: U4.3 (A5), U5.3 (A5), U30.2 (A0), U30.14 (A0), U35.28 (CA5)
A10: U4.4 (A4), U5.4 (A4), U24.14 (S0), U35.25 (CA4)
A11: U4.5 (A3), U5.5 (A3), U24.13 (S1), U35.22 (CA3)
A12: U4.6 (A2), U5.6 (A2), U24.12 (S2), U35.18 (CA2)
A13: U4.7 (A1), U5.7 (A1), U24.11 (S3), U26.6 (A1), U35.15 (CA1)
A14: U4.8 (A0), U5.8 (A0), U24.10 (S4), U26.5 (A0), U35.12 (CA0)
ALATCH: U6.19 (CE), U7.19 (CE), U15.5 (O2a), U35.5 (Q2)
ALATCHA: U14.3 (O3b)
AUMS/L: U19.2
C0H: U30.7 (O3), U30.9 (O3)
CLKOUT: U11.11 (Cp), U14.5 (O2b), U35.1 (CLR), U37.3 (Cp)
CTS: UX.6
D0: U4.17 (Q7)
D1: U4.16 (Q6), U6.17 (B1)
D2: U4.15 (Q5), U6.16 (B2)
D3: U4.14 (Q4), U6.15 (B3)
D4: U4.13 (Q3), U6.14 (B4)
D5: U4.11 (Q2), U6.13 (B5)
D6: U4.10 (Q1), U6.12 (B6)
D7: U4.9 (Q0), U6.11 (B7)
D8: U5.17 (Q7), U7.18 (B0)
D9: U5.16 (Q6), U7.17 (B1)
D10: U5.15 (Q5), U7.16 (B2)
D11: U5.14 (Q4), U7.15 (B3)
D12: U5.13 (Q3), U7.14 (B4)
D13: U5.11 (Q2), U7.13 (B5)
D14: U5.10 (Q1), U7.12 (B6)
D15: U5.9 (Q0)
DDEN: U28.4 (DDENS), U33.10 (Q5)
DGND: SW1.1, U1.10 (IC0), U11.1 (OE), U18.15 (~EN), U22.2 (1A), U22.5 (2A), U22.11 (3A), U22.15 (OE), U27.1 (OEa), U27.19 (OEb), U35.3 (Q0), U35.32 (FS0), U35.38 (TWST)
DS1: U33.5 (Q1)
DS2: U33.6 (Q2)
DS3: U33.7 (Q3)
GND: U24.7 (DSR)
GNDPWR: U1.6 (VSS), U1.33 (VSS2)
HOLDA: U14.1 (OEa), U15.1 (OEa)
IAQ: U8.3 (Cp)
IN/D0: U6.18 (B0), U15.11 (O5b)
IO: U20.3, U21.6 (E3), U37.13 (Cd)
IOCLK: U20.5
MINI: U28.3 (MINI), U33.11 (Q6)
MOTOR: U33.9 (Q4)
unnamed: D1.1 (A), SW2.2, U24.1 (~INT)
unnamed: PU1.2, U1.5 (HOLD), U1.39 (BST1), U18.12 (A2)
unnamed: PU2.2, SW1.2, U1.32 (ALATCH), U8.2 (D), U14.17 (I3b), U15.4 (I2)
unnamed: PullUp.2, U20.13, U26.38 (DRQ), U26.39 (INTRQ), U38.5
unnamed: U1.3 (~RESET), U24.4 (CIN)
unnamed: U1.7 (READY), U19.3
unnamed: U1.8 (~INTREQ), U12.14 (GS)
unnamed: U1.9 (~NMI), U8.5 (Q)
unnamed: U1.11 (IC1), U12.9 (S0)
unnamed: U1.12 (IC2), U12.7 (S1)
unnamed: U1.13 (IC3), U12.6 (S2)
unnamed: U1.14 (R/~W), U15.2 (I1)
unnamed: U1.34 (CLKOUT), U14.15 (I2b)
unnamed: U1.35 (XTAL2), X1.2
unnamed: U1.36 (XTAL1), X1.1
unnamed: U1.37 (BST3), U18.10 (A0)
unnamed: U1.38 (BST2), U18.11 (A1)
unnamed: U1.40 (~MEM), U15.6 (I3)
unnamed: U11.2 (O0), U12.4 (I7)
unnamed: U11.5 (O1), U12.3 (I6)
unnamed: U11.6 (O2), U12.2 (I5)
unnamed: U11.9 (O3), U12.1 (I4)
unnamed: U11.12 (O4), U12.13 (I3)
unnamed: U11.15 (O5), U12.12 (I2)
unnamed: U11.16 (O6), U12.11 (I1)
unnamed: U11.19 (O7), U12.10 (IO)
unnamed: U15.15 (OEb), U16.6
unnamed: U16.5, U16.9, U20.4
unnamed: U16.8, U31.19 (CE)
unnamed: U16.2, U16.12, U21.15 (O0)
unnamed: U19.1, U38.2
unnamed: U19.11, U25.15 (E)
unnamed: U19.12, U36.8
unnamed: U6.1 (A->B), U7.1 (A->B), U20.2
unnamed: U20.6, U24.15 (CRUCLK)
unnamed: U20.8, U36.4
unnamed: U21.1 (A0), U22.9 (Y3)
unnamed: U21.2 (A1), U22.7 (Y2)
unnamed: U21.3 (A2), U22.4 (Y1)
unnamed: U22.1 (SEL), U23.3
unnamed: U24.2 (XOUT), U24.3 (RIN), U24.5 (RTS), UX.2
unnamed: U24.5 (RTS), UX.4, UX.5
unnamed: U24.6 (CTS), UY.6
unnamed: U26.15 (STEP), U27.2 (I0a)
unnamed: U26.16 (DIRC), U27.4 (I1a)
unnamed: U26.17 (EARLY), U28.13 (EARLY)
unnamed: U26.18 (LATE), U28.14 (LATE)
unnamed: U26.23 (HLT), U28.8 (HALT)
unnamed: U26.24 (CLK), U28.9 (CLK)
unnamed: U26.26 (RCLK), U28.5 (SPCLK)
unnamed: U26.27 (~RDDATA), U28.6 (~RRD)
unnamed: U26.28 (HLD), U27.17 (I3b), U28.15 (HLD)
unnamed: U26.30 (WG), U27.6 (I2a)
unnamed: U26.31 (WD), U28.12 (WD)
unnamed: U26.32 (READY), U32.3 (O3b)
unnamed: U26.34 (~TRK00), U32.14 (O2a)
unnamed: U26.36 (~WRPRT), U32.16 (O1a)
unnamed: U27.8 (I3a), U28.7 (WRDATA)
unnamed: U28.1 (~RDDATA), U32.18 (O0a)
unnamed: U28.11 (CLKIN), U29.10 (Y), U38.13
unnamed: U29.9 (GND), U29.11 (~EN)
unnamed: U35.2 (A), U38.12
unnamed: U35.6 (Q3), UM.4 (~RAS)
unnamed: U35.10 (Q1), UM.15 (~CAS)
unnamed: U35.13 (MA0), UM.5 (A0)
unnamed: U35.14 (VCC), UM.14 (A1)
unnamed: U35.19 (MA2), UM.6 (A2)
unnamed: U35.21 (MA3), UM.12 (A3)
unnamed: U35.24 (MA4), UM.11 (A4)
unnamed: U35.27 (MA5), UM.10 (A5)
unnamed: U35.32 (FS0), UM.13 (A6)
unnamed: U35.33 (MA7), UM.9 (A7)
unnamed: U35.35 (RA7), U38.12
unnamed: U36.1, U37.8 (~Q), U37.12 (D)
unnamed: U36.2, U37.2 (D), U37.6 (~Q)
unnamed: U36.3, U38.1
unnamed: U36.11, U37.1 (Cd)
unnamed: UM.2 (DI), UM.14 (A1)
OUT/D15: U15.14 (I6)
PDIO0: U26.14 (DB7), U31.18 (B0)
PDIO1: U26.13 (DB6), U31.17 (B1)
PDIO2: U26.12 (DB5), U31.16 (B2)
PDIO3: U26.11 (DB4), U31.15 (B3)
PDIO4: U26.10 (DB3), U31.14 (B4)
PDIO5: U26.9 (DB2), U31.13 (B5)
PDIO6: U26.7 (DB0), U31.12 (B6)
PDIO7: U26.8 (DB1), U31.11 (B7)
PIO: U16.11, U30.15 (E)
R/~W: PU2.2, U15.3 (O1a), U20.1
RAMSEL: U36.13
RDY2: U35.2 (A), U37.4 (Sd)
RTS: UY.4
SERIAL IN: PU3.2, U15.12 (I5), U24.4 (CIN)
SERIAL OUT: PU3.2, U15.13 (O6b), U24.8 (COUT)
SERIAL_OUT: U33.13 (D)
SIO: U16.3, U30.1 (E)
XOUT: UX.3
~A0: U16.10, U20.10
~APP: U1.4 (~APP)
~EOSEL: U25.10 (O2)
~ERRIO: U21.7 (O7)
~EXIO: U21.9 (O6)
~FDCDRQ: U11.8 (D3)
~FDCDRQ~(INT3): U38.6
~FDCINT: U11.7 (D2)
~FDCINT~(INT2): U20.12
~INT0: PU4.2, U11.3 (D0)
~INT1: U11.4 (D1)
~INT4: U11.13 (D4), U24.1 (~INT)
~INT5: U11.14 (D5)
~INT6: U11.17 (D6)
~INT7: U11.18 (D7)
~IOCLK~/~IOWR: U14.12 (O3a)
~IORD: U14.16 (O1a), U26.4 (~RD)
~IOWR: U26.2 (~WR)
~MEM: U15.7 (O3a), U18.13 (A3), U19.13
~MRD: PU2.2, U4.20 (G), U5.20 (G), U14.18 (O0a), U35.8 (Q3)
~MWE: U14.14 (O2a)
~MWR: U35.9 (Q2), UM.3 (~WE)
~PRIVIO: U21.11 (O4)
~PSEL: U38.13
~R/W~: U31.1 (A->B)
~RAMSEL: U35.4 (Q1), U36.6
~RESET: U26.19 (~MR)
~ROMSEL: U4.18 (E), U5.18 (E), U25.9 (O3), U36.5, U36.12
~SYSRESET: U8.1 (Cd), U24.6 (CTS), U33.15 (Clr), U35.36 (FS1)

Notes on the sheet:
Pull Up - Each Signal
~CXXX
IODATA HIGH BYTE
One Pull for each signal
RESET
MEMORY WAIT
IO WAIT
NMI
RS232
DTE (Serial Interface to PC Terminal)
64k DRAM Memory Space
D0-D15
D0-D7
16 DRAM ICs D0-D15 etc
3 1/2" Drive
All FDD Inputs Pulled Up
Floppy Disc Controller
Compenstaiton Connections 2-4 3-6 2-5
P0=1 P1=0 P2=1
Unused. Was used to invert CLKOUT
pin 1
PIN2
